samuel-gerin/dual-stepper-motor-evaluation-board/stepper_motor_eval_board_v1.0/jlcpcb/production_files/BOM-stepper_motor_board_v1.0.csv

Comment | Designator | Footprint | LCSC | Quantity
0 | R3 | R_0603_1608Metric | C21189 | 1
100 | R1 | R_0603_1608Metric | C22775 | 1
100k | R23 | R_0603_1608Metric | C25803 | 1
100n 50V | C1,C10,C14,C15,C16,C17,C20,C22,C23,C24,C25,C28,C3,C36,C37,C5,C7,C8,C9 | C_0603_1608Metric | C14663 | 19
100p C0G 50V | C38,C39 | C_0603_1608Metric | C14858 | 2
100µ 50V | C21,C29 | CP_Elec_6.3x7.7 | C962164 | 2
10k | R21 | R_0805_2012Metric | C17414 | 1
10k | R13,R17,R24,R25 | R_0603_1608Metric | C25804 | 4
10µ | L1 | IND_ASPI-0630HI-3R3M-T15 | C5949168 | 1
10µ 50V 1210 | C33,C34 | C_1210_3225Metric | C77102 | 2
158k | R26 | R_0603_1608Metric | C22883 | 1
180K | R22 | R_0603_1608Metric | C22827 | 1
196k | R28 | R_0603_1608Metric | C22930 | 1
1k | R4,R5 | R_0603_1608Metric | C21190 | 2
1k5 | R11,R30 | R_0603_1608Metric | C22843 | 2
1µ 25V | C31,C32,C35,C4 | C_0603_1608Metric | C5673 | 4
2.2µ 25V | C12,C13 | C_0603_1608Metric | C57895 | 2
2.2µ 25V | C19,C27 | C_0603_1608Metric | C99228 | 2
220m 2010 | R15,R16,R19,R20 | R_2010_5025Metric | C146381 | 4
22n 50V | C18,C26 | C_0603_1608Metric | C21122 | 2
22p C0G 50V | C2,C6 | C_0603_1608Metric | C1653 | 2
22µ 25V 1206 | C40,C41,C42,C43 | C_1206_3216Metric | C12891 | 4
2k4 | R8 | R_0603_1608Metric | C22940 | 1
30k | R27 | R_0603_1608Metric | C22984 | 1
470µ 50V | C30 | CP_Elec_10x12.5 | C22469994 | 1
4u7 25V 0805 | C11 | C_0805_2012Metric | C98195 | 1
5k1 | R10,R2,R9 | R_0603_1608Metric | C23186 | 3
62k | R29 | R_0603_1608Metric | C23221 | 1
680 | R12,R14,R18,R31,R32,R6,R7 | R_0603_1608Metric | C23228 | 7
6µ8 | L2 | IND_ASPI-0630HI-3R3M-T15 | C2046638 | 1
8MHz | Y1 | Crystal_SMD_5032-2Pin_5.0x3.2mm | C20617998 | 1
AM26LV32EIDRG4 | U5,U8 | SOIC-16_3.9x9.9mm_P1.27mm | C527448 | 2
AP2112K-3.3TRG1 | U14 | SOT-25-5_L2.9-W1.6-P0.95-LS2.8-BL | C51118 | 1
AP63200WU-7 | U12,U13 | TSOT-23-6 | C2071868 | 2
BZX84C15LT1G | D9 | SOT-23 | C80857 | 1
FTSH-107-01-L-DV-K | CN1 | HDR-SMD_14P-P1.27_FTSH-107-01-L-DV-K | C5307809 | 1
R_LED | D1,D11,D12,D13,D14,D2,D3,D4,D5,D7 | LED_0603_1608Metric | C2286 | 10
SMAJ24A | D6,D8 | D_SMA | C19077541 | 2
SMBJ24A | D10 | D_SMB | C19077578 | 1
SQD50P04-13L_T4GE3-HXY | Q1 | TO-252-2 | C49256455 | 1
STM32G431CBT6 | U1 | LQFP-48_7x7mm_P0.5mm | C529355 | 1
SW_Push | SW1,SW2 | KEY-SMD_4P-L6.0-W6.0-P4.50-LS8.6 | C381044 | 2
TMC2209-LA | U10,U7 | VQFN-28-1EP_5x5mm_P0.5mm_EP3.7x3.7mm_ThermalVias | C2150710 | 2
TPD4E05U06DQAR | U2 | USON-10_2.5x1.0mm_P0.5mm | C138714 | 1
TPD6E05U06RVZR | U6,U9 | Texas_R-PUSON-N14 | C962978 | 2
TPS2116DRL | U11 | SOT-583-8 | C3235557 | 1
TestPoint | TP49,TP51,TP55 | TestPoint_Keystone_5001_Miniature | C238122 | 3
TestPoint | TP1,TP10,TP11,TP12,TP13,TP14,TP15,TP18,TP19,TP2,TP20,TP3,TP31,TP32,TP33,TP34,TP35,TP4,TP46,TP47,TP5,TP6,TP7,TP8,TP9 | TestPoint_Keystone_5002_Miniature | C238123 | 25
TestPoint | TP16,TP17,TP48,TP50,TP52,TP56 | TestPoint_Keystone_5000_Miniature | C5199900 | 6
USBLC6-2SC6 | U3 | SOT-23-6 | C7519 | 1
USB_C_Receptacle_USB2.0_16P | J2 | USB_C_Receptacle_GCT_USB4105-xx-A_16P_TopMnt_Horizontal | C3020560 | 1
