samuel-gerin/dual-stepper-motor-evaluation-board/(list of files, drawings)

Other design files:
simulation_models/sqd50p04-13l/SQD50P04-13L_PS.olb
simulation_models/sqd50p04-13l/SQD50P04-13L_PS_RC.OLB
