samuel-gerin/dual-stepper-motor-evaluation-board/stepper_motor_eval_board_v1.0/stepper_motor_eval_board_v1.0.kicad_pcb

## KiCad design stepper_motor_eval_board_v1.0/stepper_motor_eval_board_v1.0.kicad_pcb (2026-11-13)

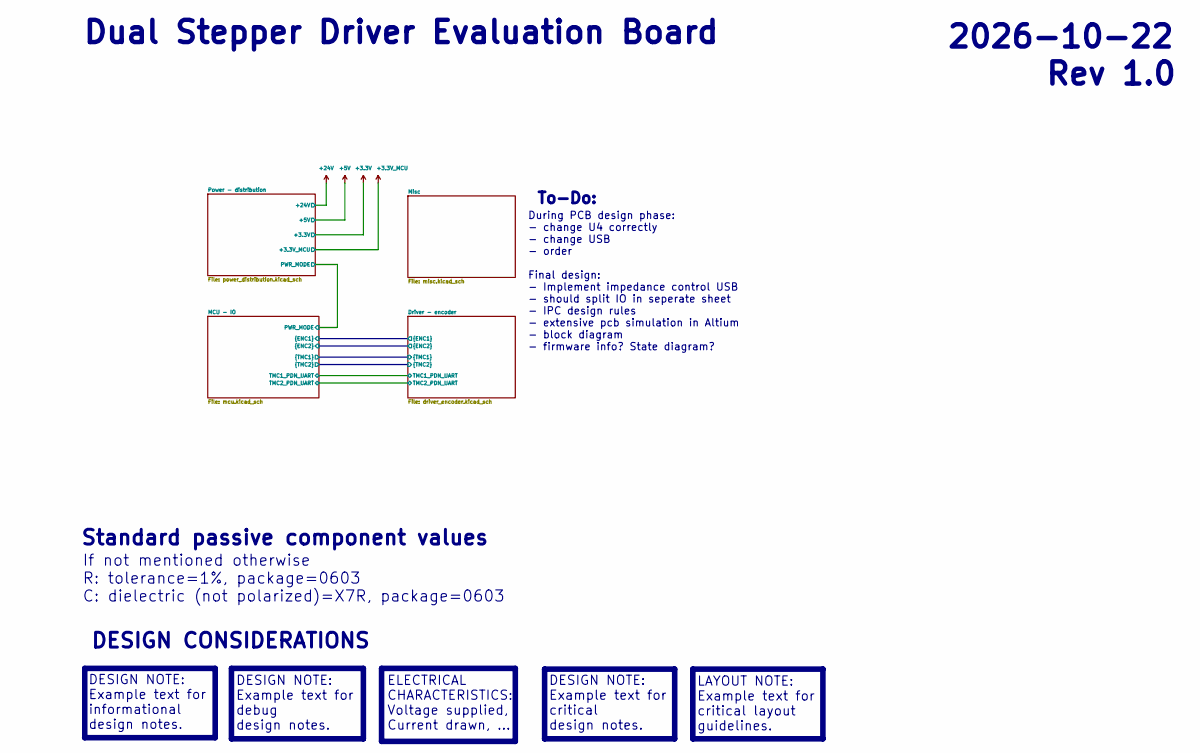
[picture p6: schematic stepper_motor_eval_board_v1.0.kicad_sch, Stepper Motor Evaluation Board]

Notes on the sheet:
Dual Stepper Driver Evaluation Board
ELECTRICAL CHARACTERISTICS: Voltage supplied, Current drawn, ...
During PCB design phase: - change U4 correctly - change USB - order Final design: - Implement impedance control USB - should split IO in seperate sheet - IPC design rules - extensive pcb simulation in Altium - block diagram - firmware info? State diagram?
To-Do:
2026-10-22
Rev 1.0
DESIGN NOTE: Example text for informational design notes.
DESIGN NOTE: Example text for critical design notes.
If not mentioned otherwise R: tolerance=1%, package=0603 C: dielectric (not polarized)=X7R, package=0603
DESIGN NOTE: Example text for debug design notes.
Standard passive component values
DESIGN CONSIDERATIONS
LAYOUT NOTE: Example text for critical layout guidelines.

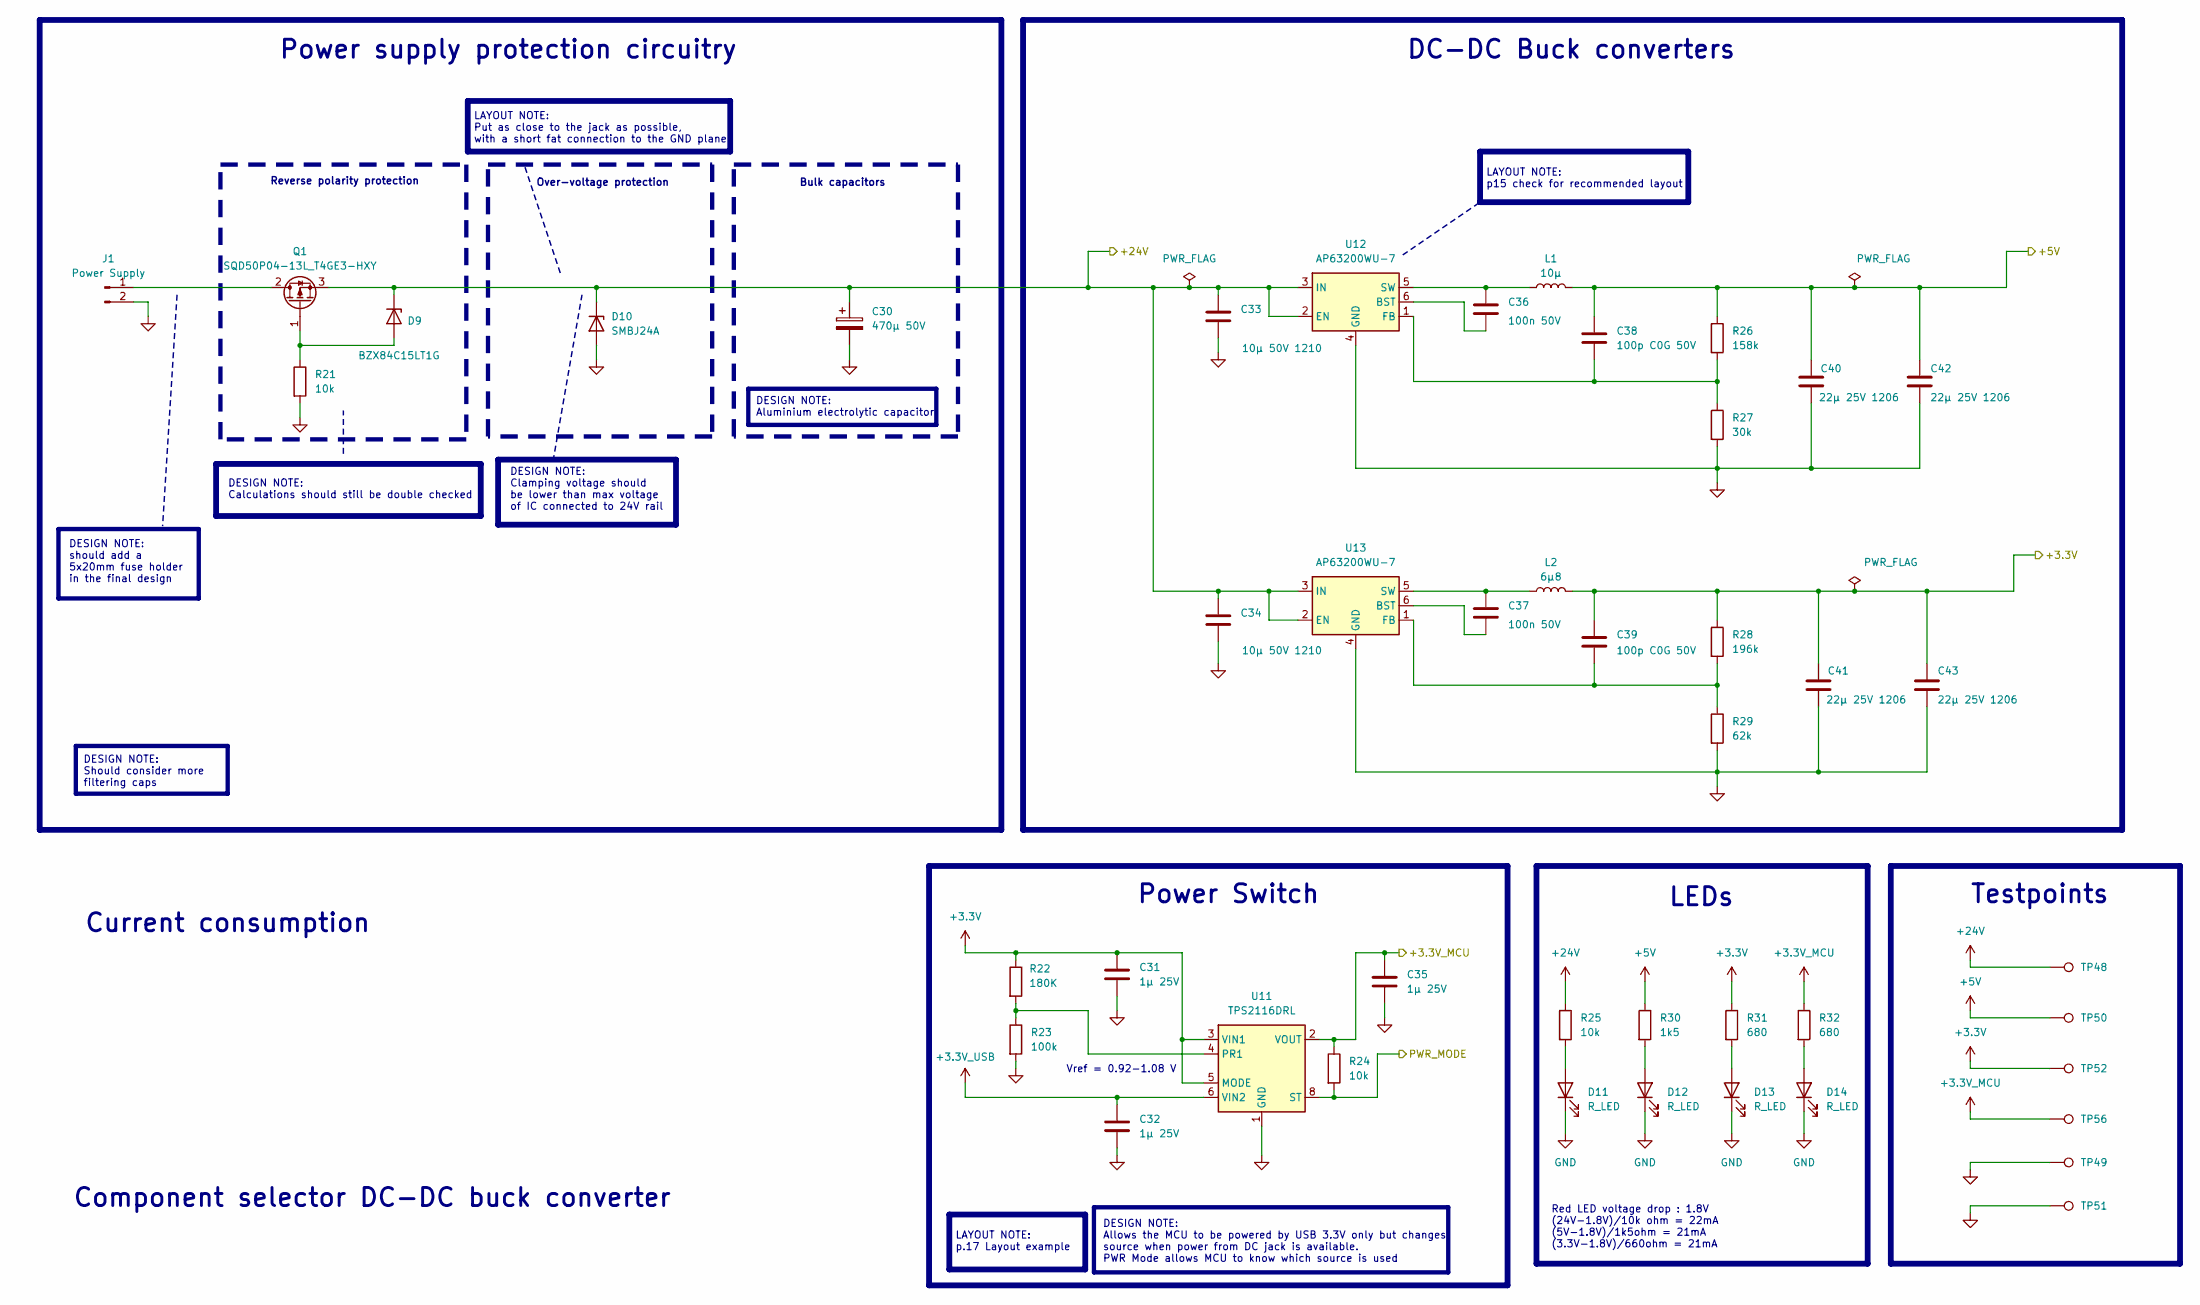
[picture p7: schematic power_distribution.kicad_sch]

Parts:
C30: 470µ 50V; CP_Elec_10x12.5; LCSC C22469994
C31, C32, C35: 1µ 25V; C_0603_1608Metric; LCSC C5673
C33, C34: 10µ 50V 1210; C_1210_3225Metric; LCSC C77102
C36, C37: 100n 50V; C_0603_1608Metric; LCSC C14663
C38, C39: 100p C0G 50V; C_0603_1608Metric; LCSC C14858
C40, C41, C42, C43: 22µ 25V 1206; C_1206_3216Metric; LCSC C12891
D9: BZX84C15LT1G; SOT-23; LCSC C80857
D10: SMBJ24A; D_SMB; LCSC C19077578
D11, D12, D13, D14: R_LED; LED_0603_1608Metric; LCSC C2286
J1: Power Supply; TerminalBlock_Phoenix_MKDS-1,5-2-5.08_1x02_P5.08mm_Horizont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
L1: 10µ; IND_ASPI-0630HI-3R3M-T15; LCSC C5949168
L2: 6µ8; IND_ASPI-0630HI-3R3M-T15; LCSC C2046638
Q1: SQD50P04-13L_T4GE3-HXY; TO-252-2; LCSC C49256455
R21: 10k; R_0805_2012Metric; LCSC C17414
R22: 180K; R_0603_1608Metric; LCSC C22827
R23: 100k; R_0603_1608Metric; LCSC C25803
R24, R25: 10k; R_0603_1608Metric; LCSC C25804
R26: 158k; R_0603_1608Metric; LCSC C22883
R27: 30k; R_0603_1608Metric; LCSC C22984
R28: 196k; R_0603_1608Metric; LCSC C22930
R29: 62k; R_0603_1608Metric; LCSC C23221
R30: 1k5; R_0603_1608Metric; LCSC C22843
R31, R32: 680; R_0603_1608Metric; LCSC C23228
TP48, TP50, TP52, TP56: TestPoint; TestPoint_Keystone_5000_Miniature; LCSC C5199900
TP49, TP51: TestPoint; TestPoint_Keystone_5001_Miniature; LCSC C238122
U11: TPS2116DRL; SOT-583-8; LCSC C3235557
U12, U13: AP63200WU-7; TSOT-23-6; LCSC C2071868

Connections:
+3.3V: C31.1, C39.1, C41.1, C43.1, L2.2, R22.1, R28.1, R31.1, TP52.1 (1_1), U11.3 (VIN1), U11.5 (MODE); also elsewhere on the board
+3.3V_MCU: C35.1, R24.1, R32.1, TP56.1 (1_1), U11.2 (VOUT), U11.7 (VOUT); also elsewhere on the board
+3.3V_USB: C32.1, U11.6 (VIN2); also elsewhere on the board
+5V: C38.1, C40.1, C42.1, L1.2, R26.1, R30.1, TP50.1 (1_1); also elsewhere on the board
+24V: C30.1, C33.1, C34.1, D9.3 (K), D10.1 (K), Q1.3 (S), R25.1, TP48.1 (1_1), U12.2 (EN), U12.3 (IN), U13.2 (EN), U13.3 (IN); also elsewhere on the board
/MCU - IO/PWR_MODE: R24.2, U11.8 (ST); also elsewhere on the board
GND: C30.2, C31.2, C32.2, C33.2, C34.2, C35.2, C40.2, C41.2, C42.2, C43.2, D10.2 (A), D11.1 (K), D12.1 (K), D13.1 (K), D14.1 (K), J1.2, R21.2, R23.2, R27.2, R29.2, TP49.1 (1_1), TP51.1 (1_1), U11.1 (GND), U12.4 (GND), U13.4 (GND); also elsewhere on the board
unnamed: D9.1 (A), Q1.1 (G), R21.1
unnamed: D11.2 (A), R25.2
unnamed: D12.2 (A), R30.2
unnamed: D13.2 (A), R31.2
unnamed: D14.2 (A), R32.2
unnamed: J1.1, Q1.2 (D)
unnamed: R22.2, R23.1, U11.4 (PR1)
unnamed: C36.1, U12.6 (BST)
unnamed: C38.2, R26.2, R27.1, U12.1 (FB)
unnamed: C36.2, L1.1, U12.5 (SW)
unnamed: C37.1, U13.6 (BST)
unnamed: C39.2, R28.2, R29.1, U13.1 (FB)
unnamed: C37.2, L2.1, U13.5 (SW)

Notes on the sheet:
Red LED voltage drop : 1.8V (24V-1.8V)/10k ohm = 22mA (5V-1.8V)/1k5ohm = 21mA (3.3V-1.8V)/660ohm = 21mA
Reverse polarity protection
Power Switch
LEDs
Testpoints
LAYOUT NOTE: Put as close to the jack as possible, with a short fat connection to the GND plane
DESIGN NOTE: Calculations should still be double checked
DC-DC Buck converters
Over-voltage protection
Component selector DC-DC buck converter
Bulk capacitors
DESIGN NOTE: should add a 5x20mm fuse holder in the final design
LAYOUT NOTE: p15 check for recommended layout
DESIGN NOTE: Allows the MCU to be powered by USB 3.3V only but changes source when power from DC jack is available. PWR Mode allows MCU to know which source is used
DESIGN NOTE: Should consider more filtering caps
LAYOUT NOTE: p.17 Layout example
DESIGN NOTE: Aluminium electrolytic capacitor
Current consumption
Vref = 0.92-1.08 V
Power supply protection circuitry
DESIGN NOTE: Clamping voltage should be lower than max voltage of IC connected to 24V rail

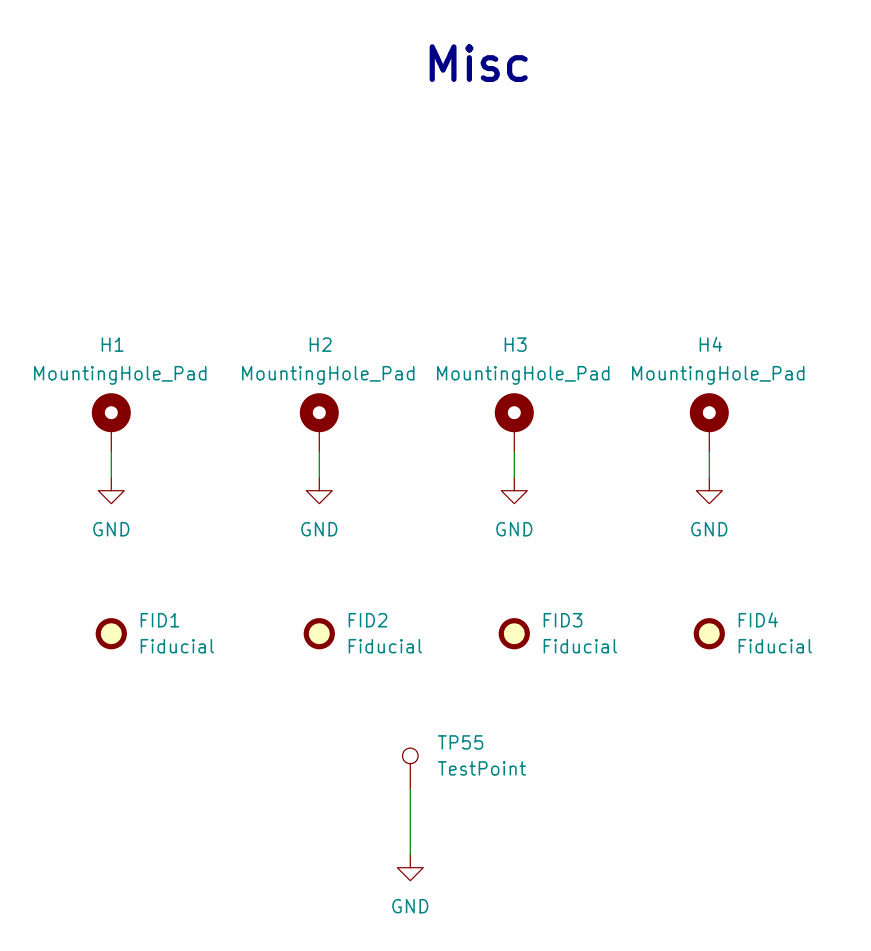
[picture p8: schematic misc.kicad_sch]

Parts:
FID1, FID2, FID3, FID4: Fiducial; Fiducial_1mm_Mask2mm
H1, H2, H3, H4: MountingHole_Pad; MountingHole_3.2mm_M3_Pad_Via
TP55: TestPoint; TestPoint_Keystone_5001_Miniature; LCSC C238122

Connections:
GND: H1.1 (1_1), H2.1 (1_1), H3.1 (1_1), H4.1 (1_1), TP55.1 (1_1); also elsewhere on the board

Notes on the sheet:
Misc

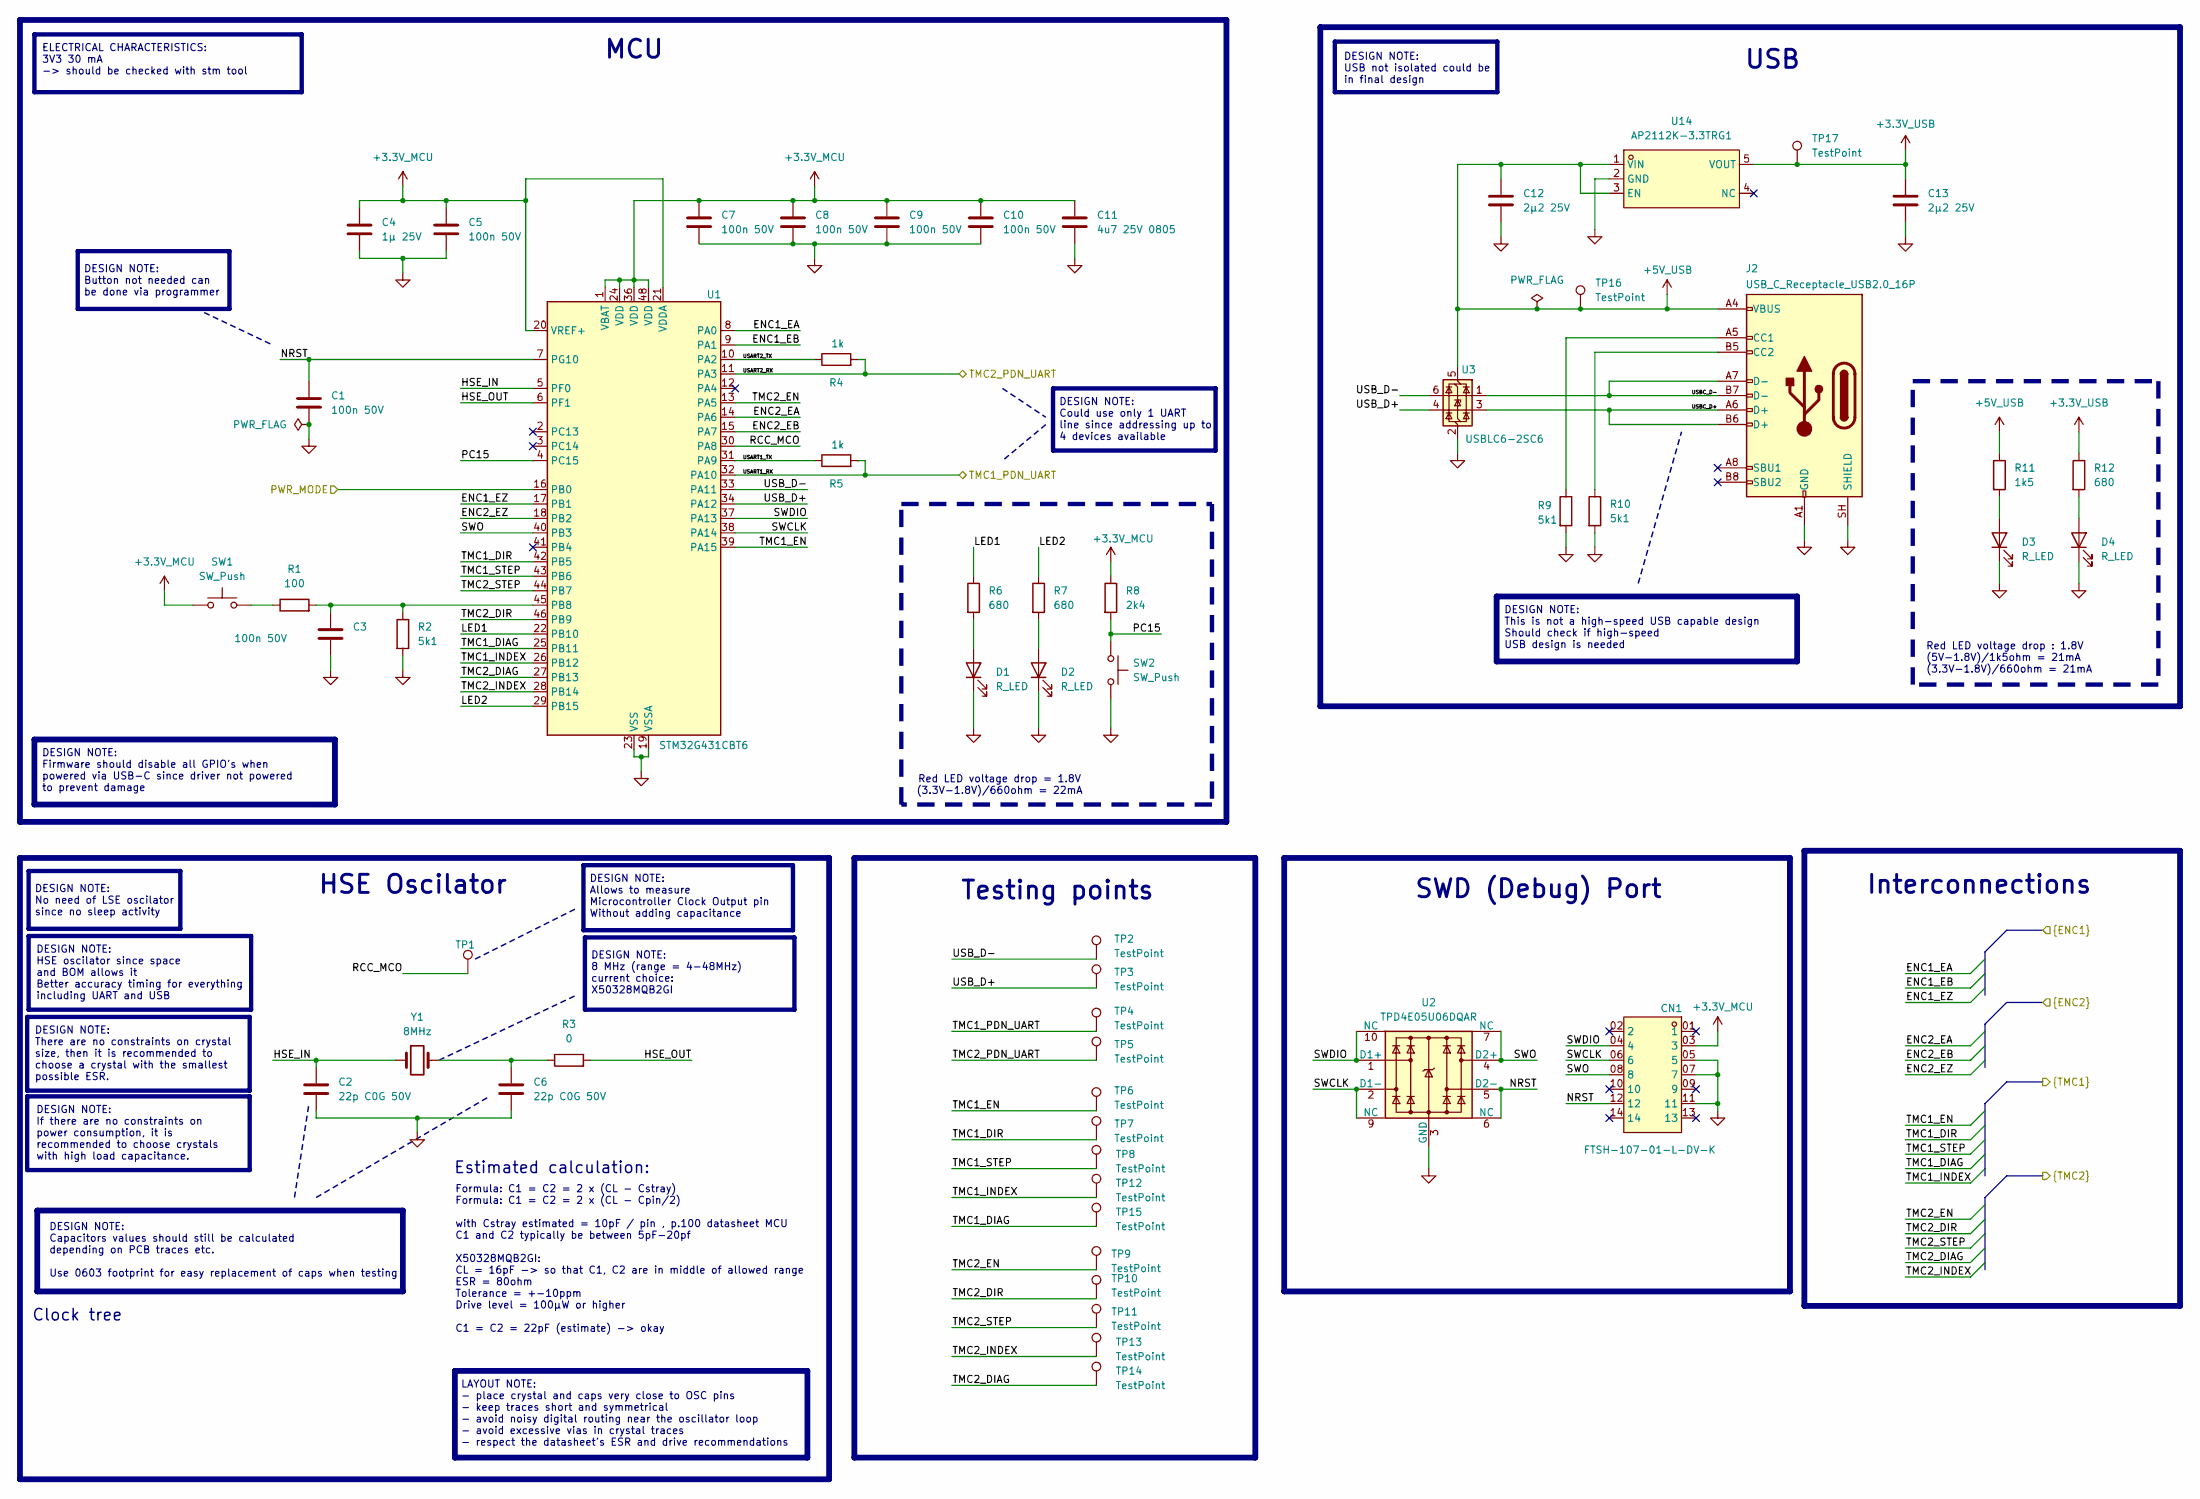
[picture p9: schematic mcu.kicad_sch]

Parts:
C1, C3, C5, C7, C8, C9, C10: 100n 50V; C_0603_1608Metric; LCSC C14663
C2, C6: 22p C0G 50V; C_0603_1608Metric; LCSC C1653
C4: 1µ 25V; C_0603_1608Metric; LCSC C5673
C11: 4u7 25V 0805; C_0805_2012Metric; LCSC C98195
C12, C13: 2µ2 25V; C_0603_1608Metric; LCSC C57895
CN1: FTSH-107-01-L-DV-K; HDR-SMD_14P-P1.27_FTSH-107-01-L-DV-K; MPN FTSH-107-01-L-DV-K; LCSC Part C5307809
D1, D2, D3, D4: R_LED; LED_0603_1608Metric; LCSC C2286
J2: USB_C_Receptacle_USB2.0_16P; USB_C_Receptacle_GCT_USB4105-xx-A_16P_TopMnt_Horizontal; LCSC C3020560
R1: 100; R_0603_1608Metric; LCSC C22775
R2, R9, R10: 5k1; R_0603_1608Metric; LCSC C23186
R3: 0; R_0603_1608Metric; LCSC C21189
R4, R5: 1k; R_0603_1608Metric; LCSC C21190
R6, R7, R12: 680; R_0603_1608Metric; LCSC C23228
R8: 2k4; R_0603_1608Metric; LCSC C22940
R11: 1k5; R_0603_1608Metric; LCSC C22843
SW1, SW2: SW_Push; KEY-SMD_4P-L6.0-W6.0-P4.50-LS8.6; LCSC C381044
TP1, TP2, TP3, TP4, TP5, TP6, TP7, TP8, TP9, TP10, TP11, TP12, TP13, TP14, TP15: TestPoint; TestPoint_Keystone_5002_Miniature; LCSC C238123
TP16, TP17: TestPoint; TestPoint_Keystone_5000_Miniature; LCSC C5199900
U1: STM32G431CBT6; LQFP-48_7x7mm_P0.5mm; LCSC C529355
U2: TPD4E05U06DQAR; USON-10_2.5x1.0mm_P0.5mm; LCSC C138714
U3: USBLC6-2SC6; SOT-23-6; LCSC C7519
U14: AP2112K-3.3TRG1; SOT-25-5_L2.9-W1.6-P0.95-LS2.8-BL; MPN AP2112K-3.3TRG1; LCSC Part C51118
Y1: 8MHz; Crystal_SMD_5032-2Pin_5.0x3.2mm; LCSC C20617998

Connections:
+3.3V_MCU: C4.1, C5.1, C7.1, C8.1, C9.1, C10.1, C11.1, CN1.03 (3), R8.1, SW1.1, U1.1 (VBAT), U1.20 (VREF+), U1.21 (VDDA), U1.24 (VDD), U1.36 (VDD), U1.48 (VDD); also elsewhere on the board
+3.3V_USB: C13.1, R12.1, TP17.1 (1_1), U14.5 (VOUT); also elsewhere on the board
+5V_USB: C12.1, J2.A4 (VBUS), J2.A9 (VBUS), J2.B4 (VBUS), J2.B9 (VBUS), R11.1, TP16.1 (1_1), U3.5 (VBUS), U14.1 (VIN), U14.3 (EN)
/Driver - encoder/ENC1_EA: U1.8 (PA0); also elsewhere on the board
/Driver - encoder/ENC1_EB: U1.9 (PA1); also elsewhere on the board
/Driver - encoder/ENC1_EZ: U1.17 (PB1); also elsewhere on the board
/Driver - encoder/ENC2_EA: U1.14 (PA6); also elsewhere on the board
/Driver - encoder/ENC2_EB: U1.15 (PA7); also elsewhere on the board
/Driver - encoder/ENC2_EZ: U1.18 (PB2); also elsewhere on the board
/Driver - encoder/TMC1_DIAG: TP15.1 (1_1), U1.25 (PB11); also elsewhere on the board
/Driver - encoder/TMC1_DIR: TP7.1 (1_1), U1.42 (PB5); also elsewhere on the board
/Driver - encoder/TMC1_EN: TP6.1 (1_1), U1.39 (PA15); also elsewhere on the board
/Driver - encoder/TMC1_INDEX: TP12.1 (1_1), U1.26 (PB12); also elsewhere on the board
/Driver - encoder/TMC1_STEP: TP8.1 (1_1), U1.43 (PB6); also elsewhere on the board
/Driver - encoder/TMC2_DIAG: TP14.1 (1_1), U1.27 (PB13); also elsewhere on the board
/Driver - encoder/TMC2_DIR: TP10.1 (1_1), U1.46 (PB9); also elsewhere on the board
/Driver - encoder/TMC2_EN: TP9.1 (1_1), U1.13 (PA5); also elsewhere on the board
/Driver - encoder/TMC2_INDEX: TP13.1 (1_1), U1.28 (PB14); also elsewhere on the board
/Driver - encoder/TMC2_STEP: TP11.1 (1_1), U1.44 (PB7); also elsewhere on the board
/MCU - IO/HSE_IN: C2.1, U1.5 (PF0), Y1.1
/MCU - IO/HSE_OUT: R3.2, U1.6 (PF1)
/MCU - IO/LED1: R6.1, U1.22 (PB10)
/MCU - IO/LED2: R7.1, U1.29 (PB15)
/MCU - IO/NRST: C1.1, CN1.12, U1.7 (PG10), U2.5 (D2-), U2.6 (NC)
/MCU - IO/PC15: R8.2, SW2.1, U1.4 (PC15)
/MCU - IO/PWR_MODE: U1.16 (PB0); also elsewhere on the board
/MCU - IO/RCC_MCO: TP1.1 (1_1), U1.30 (PA8)
/MCU - IO/SWCLK: CN1.06 (6), U1.38 (PA14), U2.2 (D1-), U2.9 (NC)
/MCU - IO/SWDIO: CN1.04 (4), U1.37 (PA13), U2.1 (D1+), U2.10 (NC)
/MCU - IO/SWO: CN1.08 (8), U1.40 (PB3), U2.4 (D2+), U2.7 (NC)
/MCU - IO/TMC1_PDN_UART: R5.2, TP4.1 (1_1), U1.32 (PA10); also elsewhere on the board
/MCU - IO/TMC2_PDN_UART: R4.2, TP5.1 (1_1), U1.11 (PA3); also elsewhere on the board
/MCU - IO/USART1_TX: R5.1, U1.31 (PA9)
/MCU - IO/USART2_TX: R4.1, U1.10 (PA2)
/MCU - IO/USBC_D+: J2.A6 (D+), J2.B6 (D+), U3.3 (I/O2)
/MCU - IO/USBC_D-: J2.A7 (D-), J2.B7 (D-), U3.1 (I/O1)
/MCU - IO/USB_D+: TP3.1 (1_1), U1.34 (PA12), U3.4 (I/O2)
/MCU - IO/USB_D-: TP2.1 (1_1), U1.33 (PA11), U3.6 (I/O1)
GND: C1.2, C2.2, C3.2, C4.2, C5.2, C6.2, C7.2, C8.2, C9.2, C10.2, C11.2, C12.2, C13.2, CN1.05 (5), CN1.07 (7), CN1.11, D1.1 (K), D2.1 (K), D3.1 (K), D4.1 (K), J2.A1 (GND), J2.A12 (GND), J2.B1 (GND), J2.B12 (GND), J2.SH (SHIELD), R2.2, R9.2, R10.2, SW2.2, U1.19 (VSSA), U1.23 (VSS), U1.35 (VSS), U1.47 (VSS), U2.3 (GND), U2.8 (GND), U3.2 (GND), U14.2 (GND); also elsewhere on the board
unnamed: C6.1, R3.1, Y1.2
unnamed: D1.2 (A), R6.2
unnamed: D2.2 (A), R7.2
unnamed: D3.2 (A), R11.2
unnamed: D4.2 (A), R12.2
unnamed: J2.A5 (CC1), R9.1
unnamed: J2.B5 (CC2), R10.1
unnamed: R1.1, SW1.2
unnamed: C3.1, R1.2, R2.1, U1.45 (PB8)

Notes on the sheet:
Clock tree
USB
Testing points
DESIGN NOTE: This is not a high-speed USB capable design Should check if high-speed USB design is needed
SWD (Debug) Port
DESIGN NOTE: Capacitors values should still be calculated depending on PCB traces etc. Use 0603 footprint for easy replacement of caps when testing
DESIGN NOTE: No need of LSE oscilator since no sleep activity
Red LED voltage drop = 1.8V (3.3V-1.8V)/660ohm = 22mA
DESIGN NOTE: Firmware should disable all GPIO's when powered via USB-C since driver not powered to prevent damage
HSE Oscilator
DESIGN NOTE: USB not isolated could be in final design
DESIGN NOTE: There are no constraints on crystal size, then it is recommended to choose a crystal with the smallest possible ESR.
DESIGN NOTE: 8 MHz (range = 4-48MHz) current choice: X50328MQB2GI
DESIGN NOTE: Button not needed can be done via programmer
Interconnections
LAYOUT NOTE: - place crystal and caps very close to OSC pins - keep traces short and symmetrical - avoid noisy digital routing near the oscillator loop - avoid excessive vias in crystal traces - respect the datasheet's ESR and drive recommendations
DESIGN NOTE: Allows to measure Microcontroller Clock Output pin Without adding capacitance
Red LED voltage drop : 1.8V (5V-1.8V)/1k5ohm = 21mA (3.3V-1.8V)/660ohm = 21mA
Formula: C1 = C2 = 2 x (CL - Cstray) Formula: C1 = C2 = 2 x (CL - Cpin/2) with Cstray estimated = 10pF / pin , p.100 datasheet MCU C1 and C2 typically be between 5pF-20pf X50328MQB2GI: CL = 16pF -> so that C1, C2 are in middle of allowed range ESR = 80ohm Tolerance = +-10ppm Drive level = 100µW or 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
MCU
Estimated calculation:
DESIGN NOTE: If there are no constraints on power consumption, it is recommended to choose crystals with high load capacitance.
DESIGN NOTE: Could use only 1 UART line since addressing up to 4 devices available
ELECTRICAL CHARACTERISTICS: 3V3 30 mA -> should be checked with stm tool
DESIGN NOTE: HSE oscilator since space and BOM allows it Better accuracy timing for everything including UART and USB

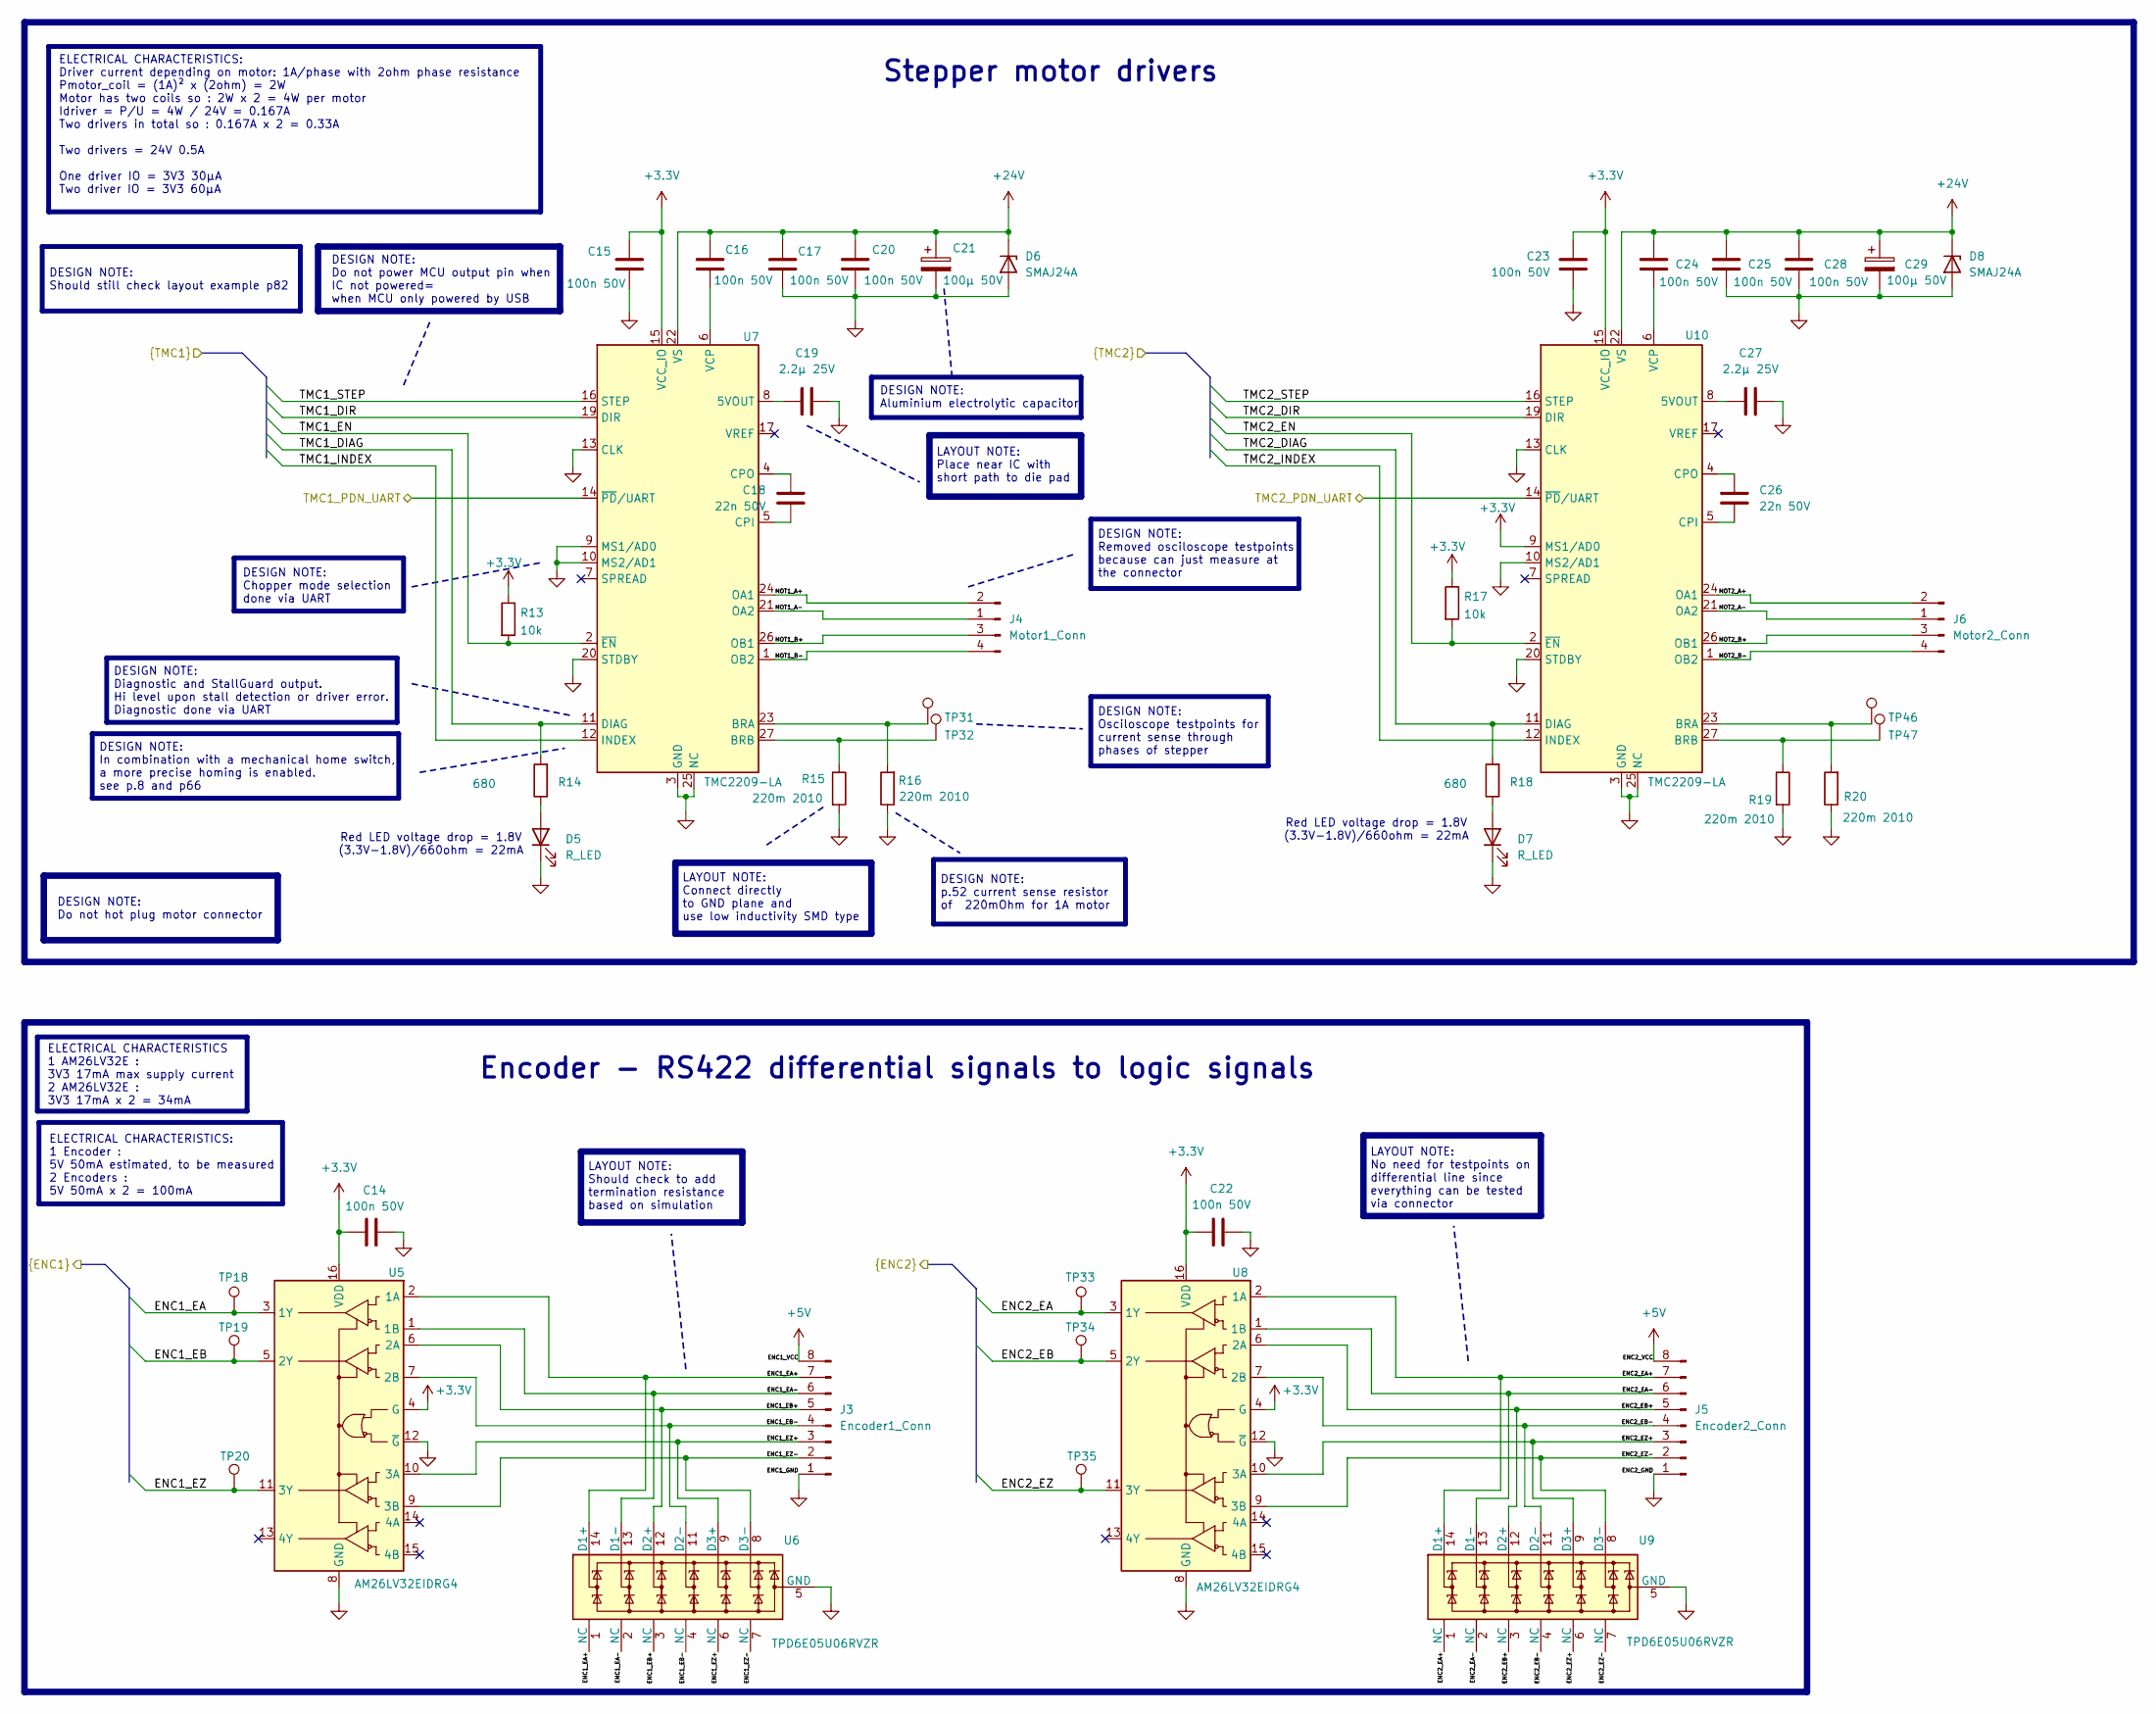
[picture p10: schematic driver_encoder.kicad_sch]

Parts:
C14, C15, C16, C17, C20, C22, C23, C24, C25, C28: 100n 50V; C_0603_1608Metric; LCSC C14663
C18, C26: 22n 50V; C_0603_1608Metric; LCSC C21122
C19, C27: 2.2µ 25V; C_0603_1608Metric; LCSC C99228
C21, C29: 100µ 50V; CP_Elec_6.3x7.7; LCSC C962164
D5, D7: R_LED; LED_0603_1608Metric; LCSC C2286
D6, D8: SMAJ24A; D_SMA; LCSC C19077541
J3: Encoder1_Conn; TerminalBlock_Phoenix_MKDS-1,5-8-5.08_1x08_P5.08mm_Horizont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
J4: Motor1_Conn; TerminalBlock_Phoenix_MKDS-1,5-4-5.08_1x04_P5.08mm_Horizont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
J5: Encoder2_Conn; TerminalBlock_Phoenix_MKDS-1,5-8-5.08_1x08_P5.08mm_Horizont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
J6: Motor2_Conn; TerminalBlock_Phoenix_MKDS-1,5-4-5.08_1x04_P5.08mm_Horizont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
R13, R17: 10k; R_0603_1608Metric; LCSC C25804
R14, R18: 680; R_0603_1608Metric; LCSC C23228
R15, R16, R19, R20: 220m 2010; R_2010_5025Metric; LCSC C146381
TP18, TP19, TP20, TP31, TP32, TP33, TP34, TP35, TP46, TP47: TestPoint; TestPoint_Keystone_5002_Miniature; LCSC C238123
U5, U8: AM26LV32EIDRG4; SOIC-16_3.9x9.9mm_P1.27mm; LCSC C527448
U6, U9: TPD6E05U06RVZR; Texas_R-PUSON-N14; LCSC C962978
U7, U10: TMC2209-LA; VQFN-28-1EP_5x5mm_P0.5mm_EP3.7x3.7mm_ThermalVias; LCSC C2150710

Connections:
+3.3V: C14.1, C15.1, C22.1, C23.1, R13.1, R17.1, U5.4 (G), U5.16 (VDD), U7.15 (VCC_IO), U8.4 (G), U8.16 (VDD), U10.9 (MS1/AD0), U10.15 (VCC_IO); also elsewhere on the board
+5V: J3.8, J5.8; also elsewhere on the board
+24V: C16.1, C17.1, C20.1, C21.1, C24.1, C25.1, C28.1, C29.1, D6.1 (K), D8.1 (K), U7.22 (VS), U7.28 (VS), U10.22 (VS), U10.28 (VS); also elsewhere on the board
/Driver - encoder/ENC1_EA: TP18.1 (1_1), U5.3 (1Y); also elsewhere on the board
/Driver - encoder/ENC1_EA+: J3.7, U5.2 (1A), U6.1 (NC), U6.14 (D1+)
/Driver - encoder/ENC1_EA-: J3.6, U5.1 (1B), U6.2 (NC), U6.13 (D1-)
/Driver - encoder/ENC1_EB: TP19.1 (1_1), U5.5 (2Y); also elsewhere on the board
/Driver - encoder/ENC1_EB+: J3.5, U5.6 (2A), U6.3 (NC), U6.12 (D2+)
/Driver - encoder/ENC1_EB-: J3.4, U5.7 (2B), U6.4 (NC), U6.11 (D2-)
/Driver - encoder/ENC1_EZ: TP20.1 (1_1), U5.11 (3Y); also elsewhere on the board
/Driver - encoder/ENC1_EZ+: J3.3, U5.10 (3A), U6.6 (NC), U6.9 (D3+)
/Driver - encoder/ENC1_EZ-: J3.2, U5.9 (3B), U6.7 (NC), U6.8 (D3-)
/Driver - encoder/ENC2_EA: TP33.1 (1_1), U8.3 (1Y); also elsewhere on the board
/Driver - encoder/ENC2_EA+: J5.7, U8.2 (1A), U9.1 (NC), U9.14 (D1+)
/Driver - encoder/ENC2_EA-: J5.6, U8.1 (1B), U9.2 (NC), U9.13 (D1-)
/Driver - encoder/ENC2_EB: TP34.1 (1_1), U8.5 (2Y); also elsewhere on the board
/Driver - encoder/ENC2_EB+: J5.5, U8.6 (2A), U9.3 (NC), U9.12 (D2+)
/Driver - encoder/ENC2_EB-: J5.4, U8.7 (2B), U9.4 (NC), U9.11 (D2-)
/Driver - encoder/ENC2_EZ: TP35.1 (1_1), U8.11 (3Y); also elsewhere on the board
/Driver - encoder/ENC2_EZ+: J5.3, U8.10 (3A), U9.6 (NC), U9.9 (D3+)
/Driver - encoder/ENC2_EZ-: J5.2, U8.9 (3B), U9.7 (NC), U9.8 (D3-)
/Driver - encoder/MOT1_A+: J4.2 (Pin_4), U7.24 (OA1)
/Driver - encoder/MOT1_A-: J4.1 (Pin_3), U7.21 (OA2)
/Driver - encoder/MOT1_B+: J4.3 (Pin_2), U7.26 (OB1)
/Driver - encoder/MOT1_B-: J4.4 (Pin_1), U7.1 (OB2)
/Driver - encoder/MOT2_A+: J6.2 (Pin_4), U10.24 (OA1)
/Driver - encoder/MOT2_A-: J6.1 (Pin_3), U10.21 (OA2)
/Driver - encoder/MOT2_B+: J6.3 (Pin_2), U10.26 (OB1)
/Driver - encoder/MOT2_B-: J6.4 (Pin_1), U10.1 (OB2)
/Driver - encoder/TMC1_DIAG: R14.2, U7.11 (DIAG); also elsewhere on the board
/Driver - encoder/TMC1_DIR: U7.19 (DIR); also elsewhere on the board
/Driver - encoder/TMC1_EN: R13.2, U7.2 (~EN); also elsewhere on the board
/Driver - encoder/TMC1_INDEX: U7.12 (INDEX); also elsewhere on the board
/Driver - encoder/TMC1_STEP: U7.16 (STEP); also elsewhere on the board
/Driver - encoder/TMC2_DIAG: R18.2, U10.11 (DIAG); also elsewhere on the board
/Driver - encoder/TMC2_DIR: U10.19 (DIR); also elsewhere on the board
/Driver - encoder/TMC2_EN: R17.2, U10.2 (~EN); also elsewhere on the board
/Driver - encoder/TMC2_INDEX: U10.12 (INDEX); also elsewhere on the board
/Driver - encoder/TMC2_STEP: U10.16 (STEP); also elsewhere on the board
/MCU - IO/TMC1_PDN_UART: U7.14 (~PD/UART); also elsewhere on the board
/MCU - IO/TMC2_PDN_UART: U10.14 (~PD/UART); also elsewhere on the board
GND: C14.2, C15.2, C17.2, C19.1, C20.2, C21.2, C22.2, C23.2, C25.2, C27.2, C28.2, C29.2, D5.1 (K), D6.2 (A), D7.1 (K), D8.2 (A), J3.1, J5.1, R15.2, R16.1, R19.2, R20.1, U5.8 (GND), U5.12 (~G), U6.5 (GND), U6.10 (GND), U7.3 (GND), U7.9 (MS1/AD0), U7.10 (MS2/AD1), U7.13 (CLK), U7.18 (GND), U7.20 (STDBY), U7.25 (NC), U7.29 (GND), U8.8 (GND), U8.12 (~G), U9.5 (GND), U9.10 (GND), U10.3 (GND), U10.10 (MS2/AD1), U10.13 (CLK), U10.18 (GND), U10.20 (STDBY), U10.25 (NC), U10.29 (GND); also elsewhere on the board
unnamed: D5.2 (A), R14.1
unnamed: D7.2 (A), R18.1
unnamed: C19.2, U7.8 (5VOUT)
unnamed: R16.2, TP31.1 (1_1), U7.23 (BRA)
unnamed: R15.1, TP32.1 (1_1), U7.27 (BRB)
unnamed: C18.2, U7.5 (CPI)
unnamed: C18.1, U7.4 (CPO)
unnamed: C16.2, U7.6 (VCP)
unnamed: C27.1, U10.8 (5VOUT)
unnamed: R20.2, TP46.1 (1_1), U10.23 (BRA)
unnamed: R19.1, TP47.1 (1_1), U10.27 (BRB)
unnamed: C26.2, U10.5 (CPI)
unnamed: C26.1, U10.4 (CPO)
unnamed: C24.2, U10.6 (VCP)

Notes on the sheet:
DESIGN NOTE: Diagnostic and StallGuard output. Hi level upon stall detection or driver error. Diagnostic done via UART
DESIGN NOTE: p.52 current sense resistor of 220mOhm for 1A motor
Encoder - RS422 differential signals to logic signals
DESIGN NOTE: In combination with a mechanical home switch, a more precise homing is enabled. see p.8 and p66
DESIGN NOTE: Removed osciloscope testpoints because can just measure at the connector
DESIGN NOTE: Aluminium electrolytic capacitor
DESIGN NOTE: Osciloscope testpoints for current sense through phases of stepper
LAYOUT NOTE: Place near IC with short path to die pad
ELECTRICAL CHARACTERISTICS 1 AM26LV32E : 3V3 17mA max supply current 2 AM26LV32E : 3V3 17mA x 2 = 34mA
LAYOUT NOTE: Should check to add termination resistance based on simulation
Red LED voltage drop = 1.8V (3.3V-1.8V)/660ohm = 22mA
DESIGN NOTE: Do not hot plug motor connector
DESIGN NOTE: Should still check layout example p82
LAYOUT NOTE: No need for testpoints on differential line since everything can be tested via connector
DESIGN NOTE: Chopper mode selection done via UART
ELECTRICAL CHARACTERISTICS: Driver current depending on motor: 1A/phase with 2ohm phase resistance Pmotor_coil = (1A)² x (2ohm) = 2W Motor has two coils so : 2W x 2 = 4W per motor Idriver = P/U = 4W / 24V = 0.167A Two drivers in total so : 0.167A x 2 = 0.33A Two drivers = 24V 0.5A One driver IO = 3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
ELECTRICAL CHARACTERISTICS: 1 Encoder : 5V 50mA estimated, to be measured 2 Encoders : 5V 50mA x 2 = 100mA
DESIGN NOTE: Do not power MCU output pin when IC not powered= when MCU only powered by USB
LAYOUT NOTE: Connect directly to GND plane and use low inductivity SMD type
Stepper motor drivers

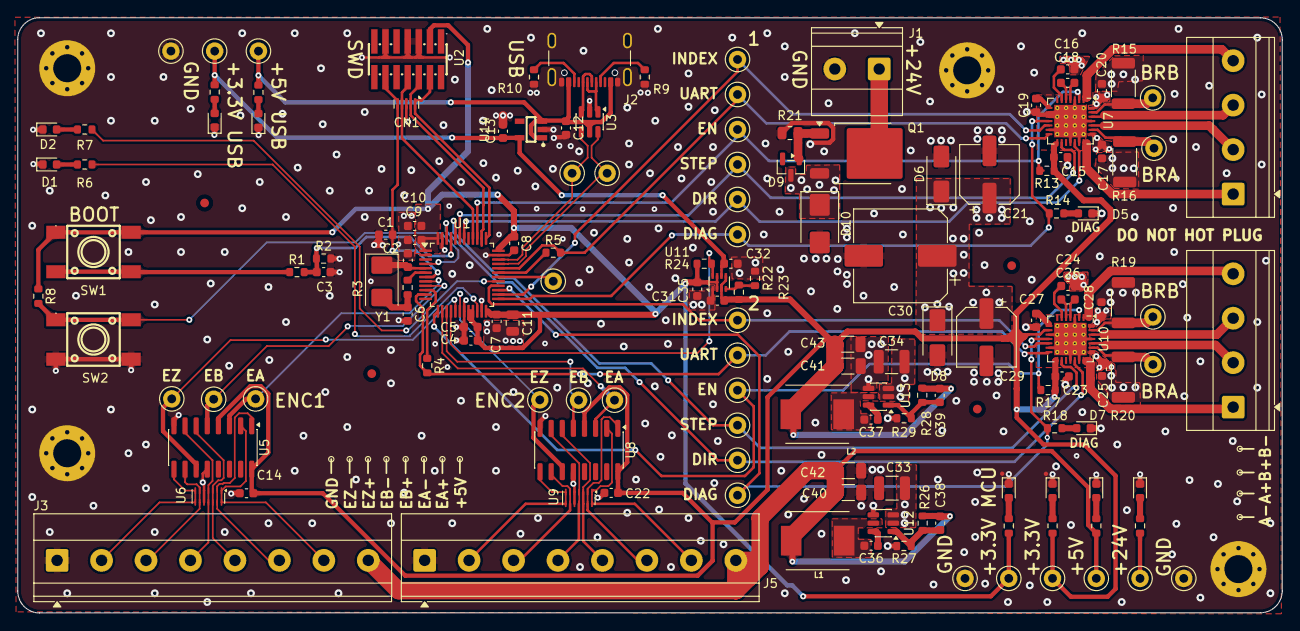
[picture p11: board stepper_motor_eval_board_v1.0.kicad_pcb from above]

Board: 4 copper layers, 144.5 x 68.0 mm, 157 parts (0 on the bottom side), 98 nets.
