samuel-gerin/dual-stepper-motor-evaluation-board/(commit log)

2026-11-02 Footprint assignments
    [driver_encoder.kicad_sch, mcu.kicad_sch, power_distribution.kicad_sch, stepper_motor_eval_board_v1.0.kicad_sch]
2026-11-03 v1.0.11 ready for pcb design
    [mcu.kicad_sch, stepper_motor_eval_board_v1.0.kicad_pcb, stepper_motor_eval_board_v1.0.kicad_sch]
2026-11-09 v1.0.34 everything wired
    [stepper_motor_eval_board_v1.0.kicad_pcb]
2026-11-09 v1.0.41 no DRC errors
    [stepper_motor_eval_board_v1.0.kicad_pcb]
2026-11-09 v1.0.41 DRC fine
    [mcu.kicad_sch, stepper_motor_eval_board_v1.0.kicad_pcb]
2026-11-09 Adding silkscreen
    [stepper_motor_eval_board_v1.0.kicad_pcb]
2026-11-10 Stop tracking pcb_pdf exports
2026-11-10 Changed .gitignore
    [stepper_motor_eval_board_v1.0.kicad_pcb]
2026-11-10 Added simulations
    [SQD50P04-13L_PS.olb, SQD50P04-13L_PS_RC.OLB, driver_encoder.kicad_sch, hot_plug.kicad_sch, power_distribution.kicad_sch, reverse_polarity.kicad_sch, stepper_motor_eval_board_v1.0.kicad_pcb, stepper_motor_eval_board_v1.0.kicad_sch]
2026-11-10 Reverse polarity simulation done
    [power_distribution.kicad_sch, reverse_polarity.kicad_sch]
2026-11-10 Starting hot plug simulation
    [hot_plug.kicad_sch, stepper_motor_eval_board_v1.0_simulation.kicad_sch]
2026-11-10 Hot plug simulation done
    [hot_plug.kicad_sch, stepper_motor_eval_board_v1.0.kicad_pcb]
